dani3l3/VLP200Sync/img/photo_work-in-progress-01.jpg

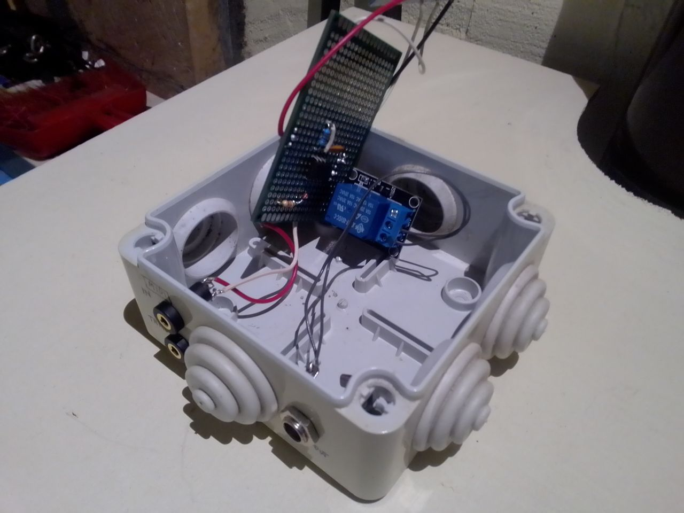
img/photo_work-in-progress-01.jpg
