dani3l3/VLP200Sync/img/photo_work-in-progress-03.jpg

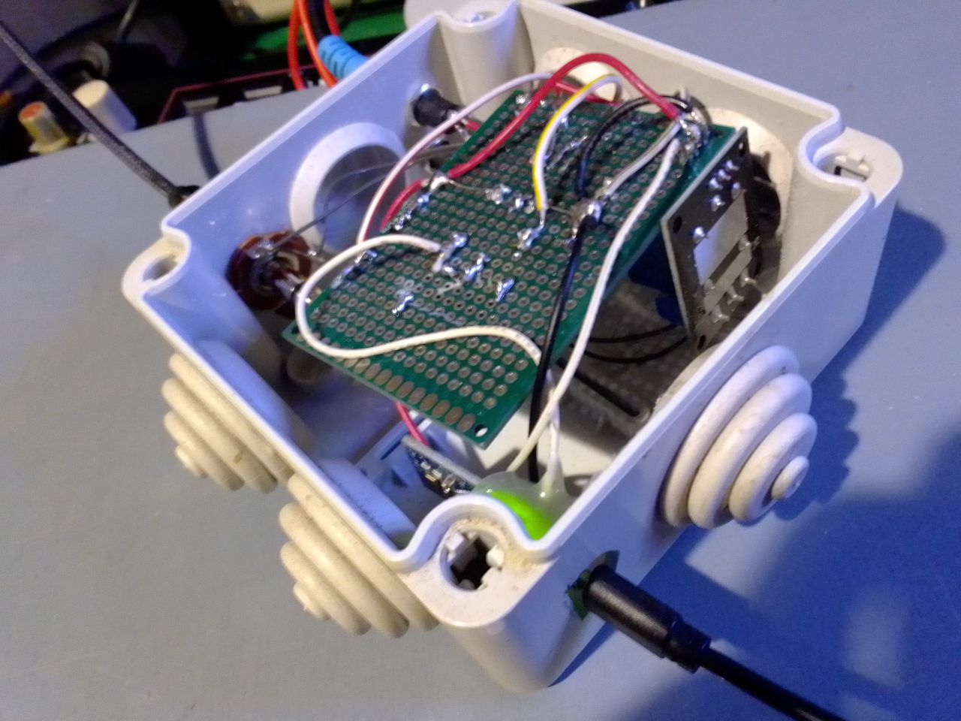
img/photo_work-in-progress-03.jpg
